tyroneous9/flight-controller/README.md

# flight-controller

# todo

- configure bms to allow i2c flash
- read sensor data
- test outputs from rf, motors
- self restart (from failure)
- signal loss
