tyroneous9/flight-controller/docs/flight_controller_schematic.pdf

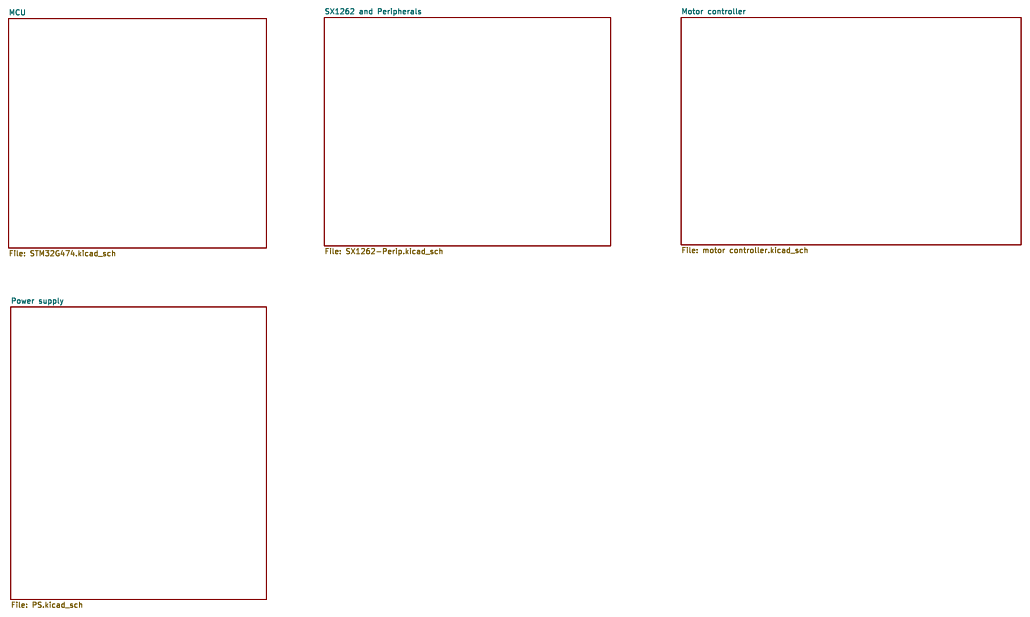
[picture p1: page 1]

Motor controller File: motor controller.kicad_sch

Id: 1/5 Title: File: clarnex123.kicad_sch Sheet: /

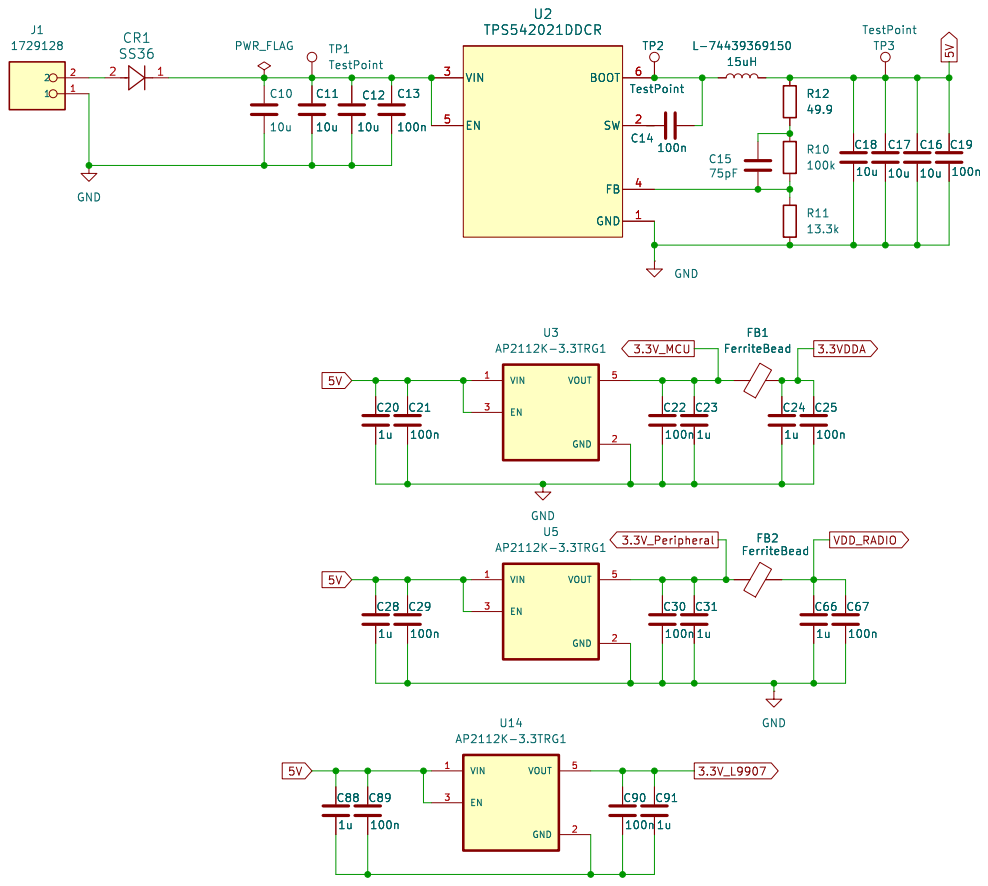
[picture p2: page 2]

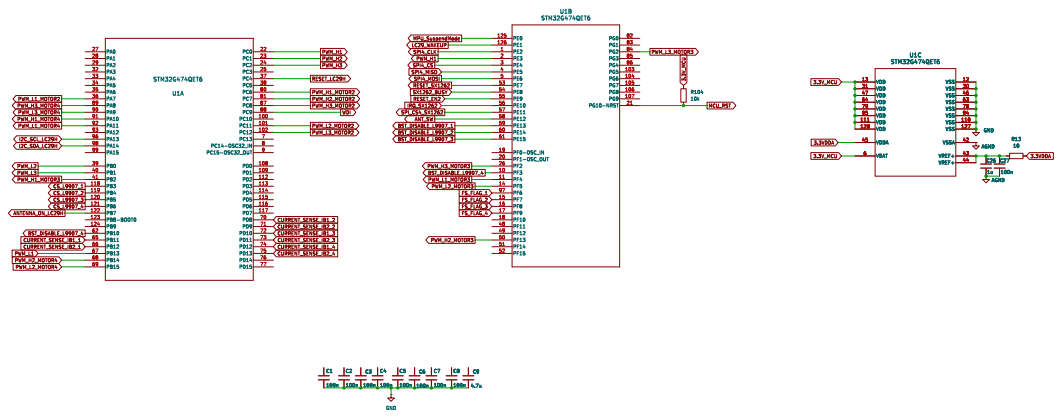
[picture p3: page 3]

Id: 3/5 Title: File: STM32G474.kicad_sch Sheet: /MCU/

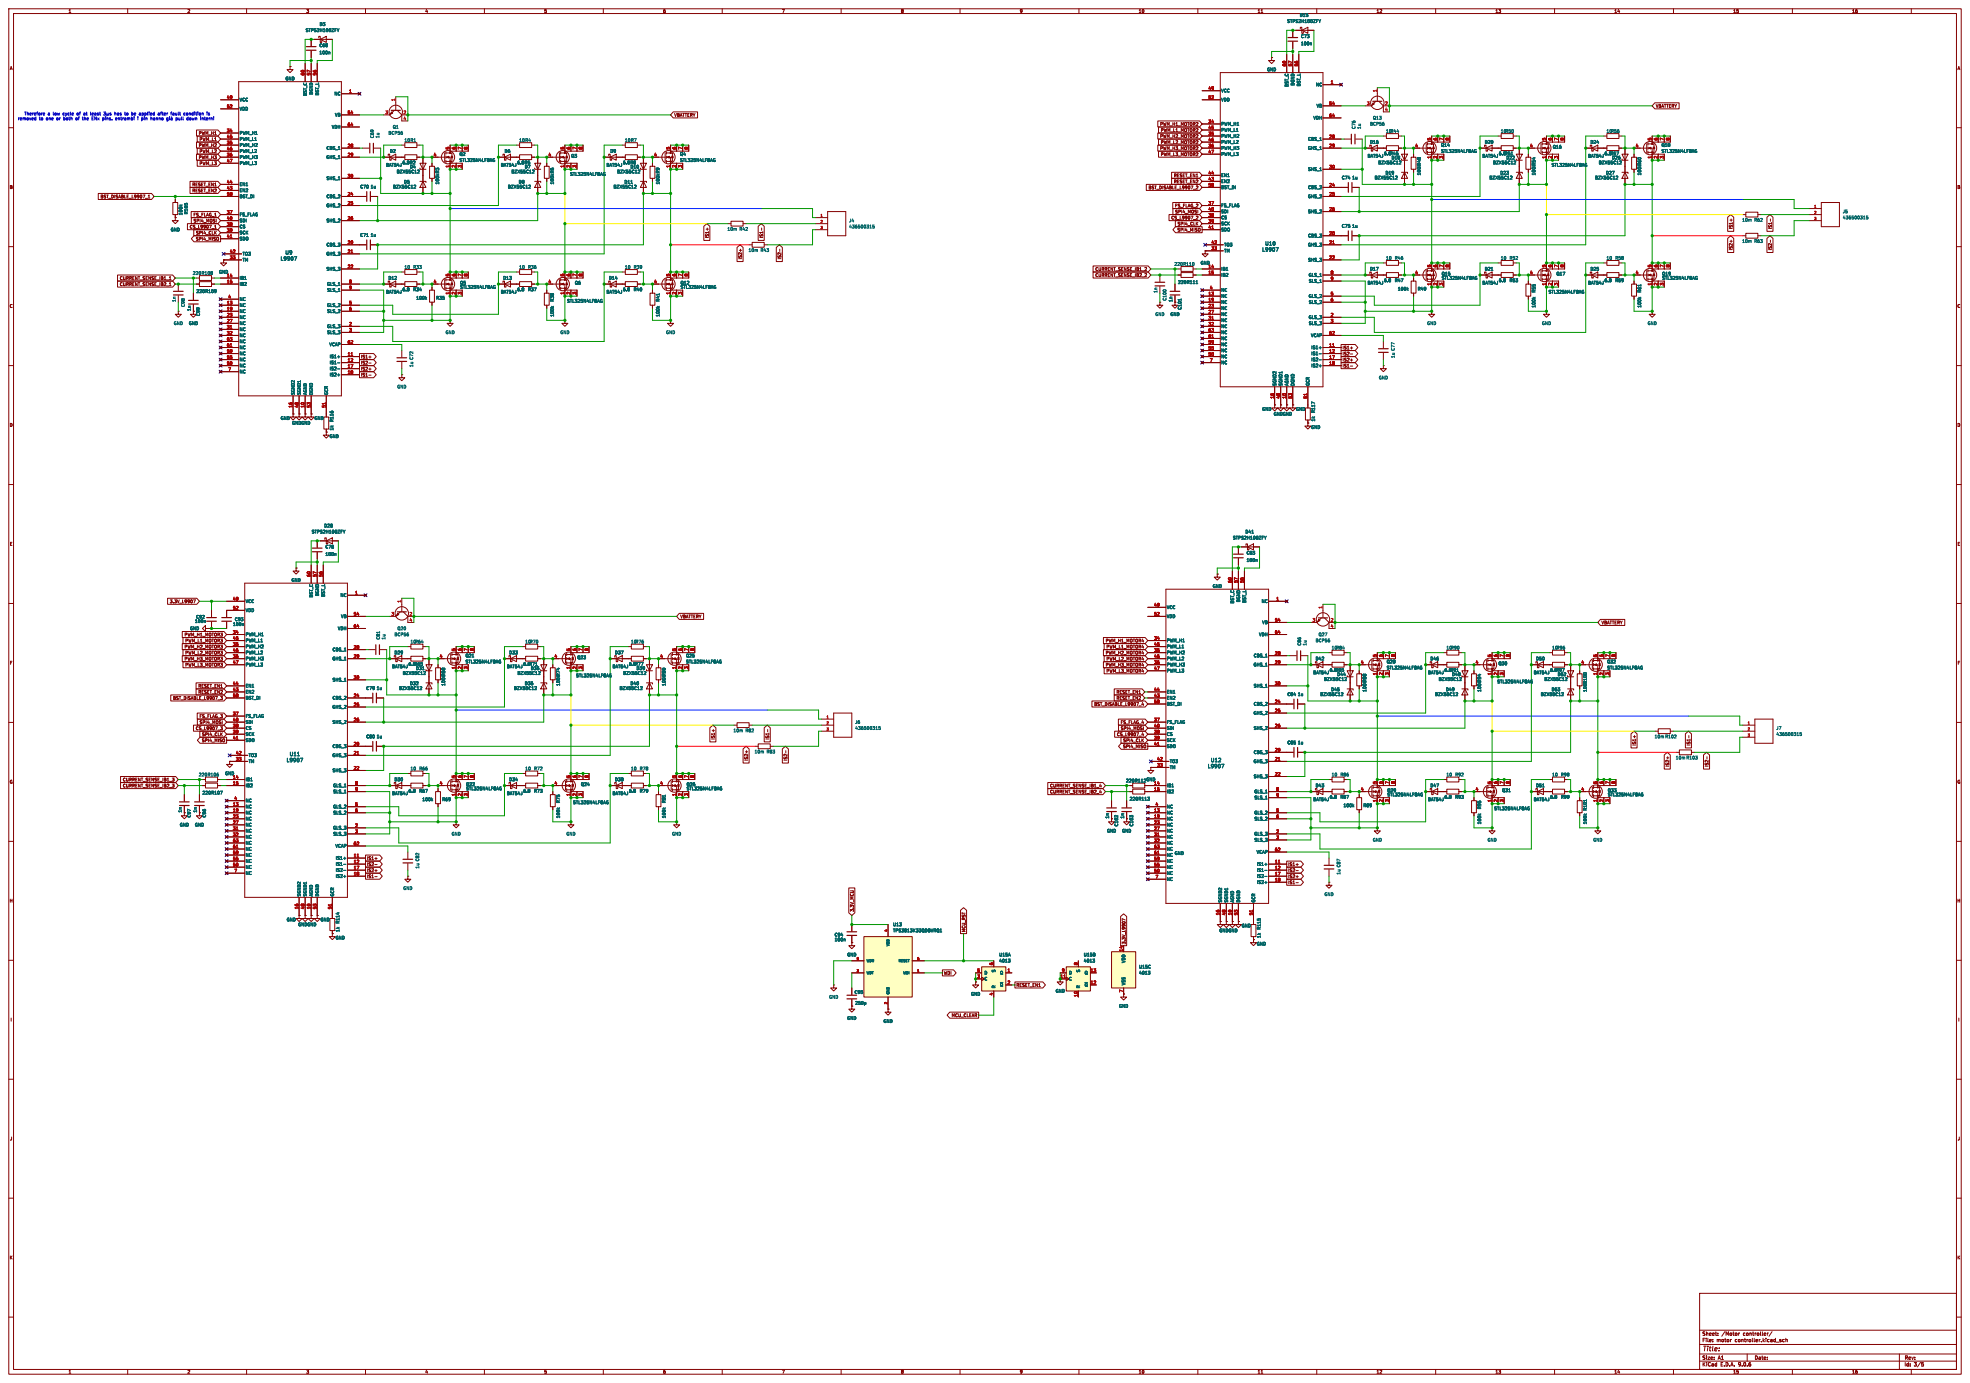
[picture p4: page 4]

GND R95 100k C87 1u R115 1k GNDGND GND GND

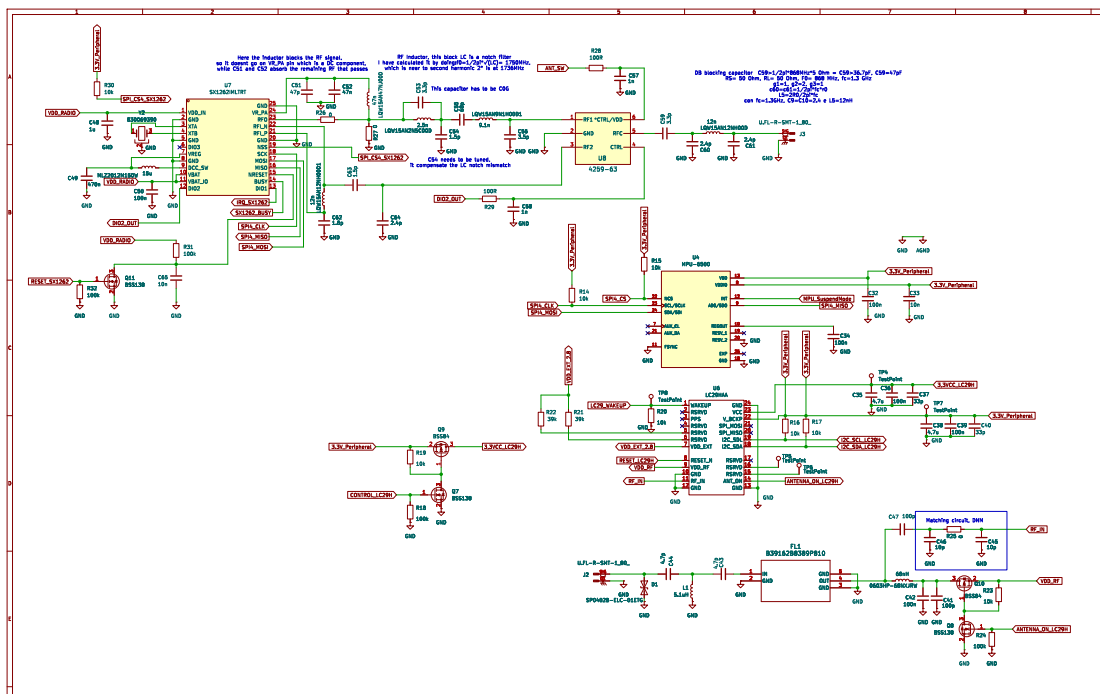
[picture p5: page 5]

C54 needs to be tuned,

I2C_SDA 18 RSRVD 17 RSRVD 16 RSRVD 15 ANT_ON 14 GND 13 R20
