tyroneous9/flight-controller/schematic/STM32G474.kicad_sch

## KiCad design schematic/STM32G474.kicad_sch (2026-10-25)

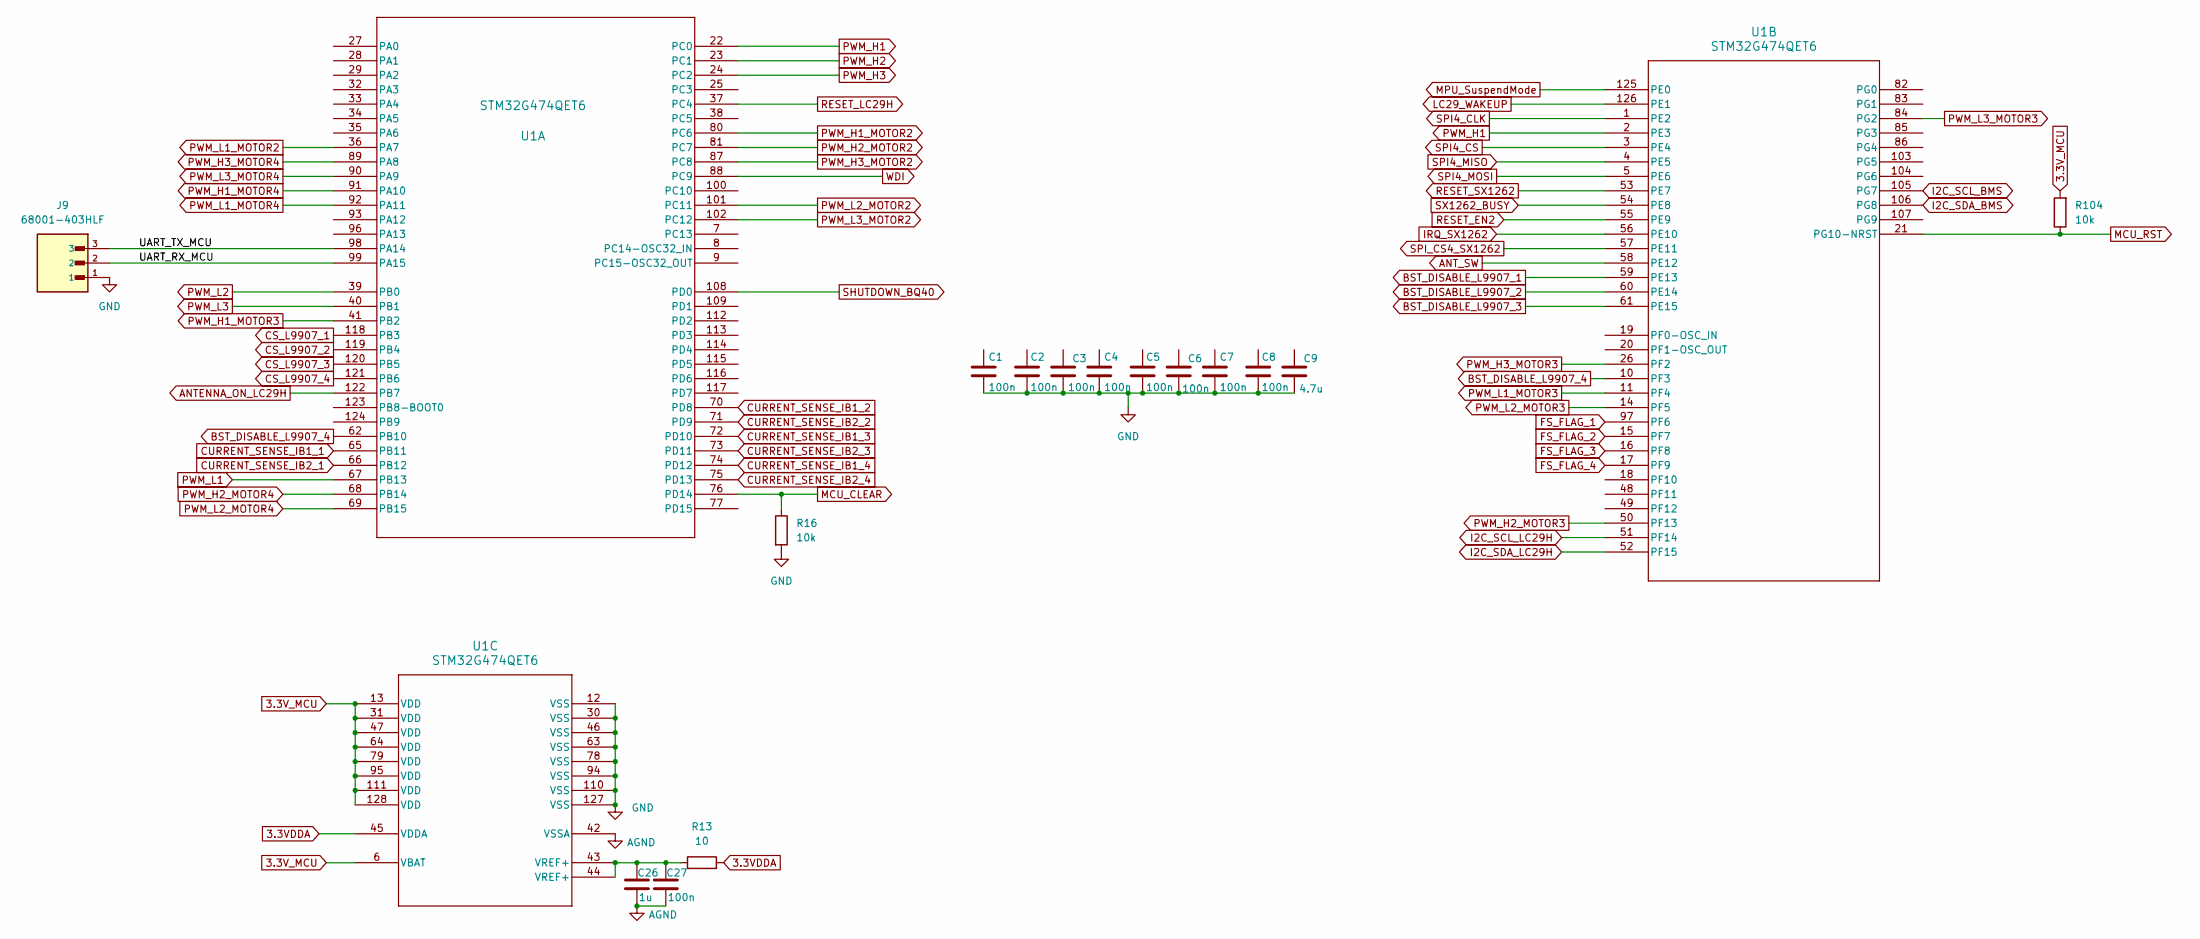
[picture p6: schematic STM32G474.kicad_sch]

Parts:
C1, C2, C3, C4, C5, C6, C7, C8, C27: 100n; C_0603_1608Metric_Pad1.08x0.95mm_HandSolder
C9: 4.7u; C_0603_1608Metric_Pad1.08x0.95mm_HandSolder
C26: 1u; C_0603_1608Metric_Pad1.08x0.95mm_HandSolder
J9: 68001-403HLF; AMPHENOL_68001-403HLF; PARTREV DG
R13: 10; R_0603_1608Metric
R16, R104: 10k; R_0603_1608Metric
U1: STM32G474QET6; LPQFP-128

Connections:
3.3VDDA: R13.2, U1.45 (VDDA)
3.3V_MCU: R104.2, U1.6 (VBAT), U1.13 (VDD), U1.31 (VDD), U1.47 (VDD), U1.64 (VDD), U1.79 (VDD), U1.95 (VDD), U1.111 (VDD), U1.128 (VDD)
ANT_SW: U1.58 (PE12)
AGND: C26.2, C27.2, U1.42 (VSSA)
ANTENNA_ON_LC29H: U1.122 (PB7)
BST_DISABLE_L9907_1: U1.59 (PE13)
BST_DISABLE_L9907_2: U1.60 (PE14)
BST_DISABLE_L9907_3: U1.61 (PE15)
BST_DISABLE_L9907_4: U1.10 (PF3), U1.62 (PB10)
CS_L9907_1: U1.118 (PB3)
CS_L9907_2: U1.119 (PB4)
CS_L9907_3: U1.120 (PB5)
CS_L9907_4: U1.121 (PB6)
CURRENT_SENSE_IB1_1: U1.65 (PB11)
CURRENT_SENSE_IB1_2: U1.70 (PD8)
CURRENT_SENSE_IB1_3: U1.72 (PD10)
CURRENT_SENSE_IB1_4: U1.74 (PD12)
CURRENT_SENSE_IB2_1: U1.66 (PB12)
CURRENT_SENSE_IB2_2: U1.71 (PD9)
CURRENT_SENSE_IB2_3: U1.73 (PD11)
CURRENT_SENSE_IB2_4: U1.75 (PD13)
FS_FLAG_1: U1.97 (PF6)
FS_FLAG_2: U1.15 (PF7)
FS_FLAG_3: U1.16 (PF8)
FS_FLAG_4: U1.17 (PF9)
GND: C1.2, C2.2, C3.2, C4.2, C5.2, C6.2, C7.2, C8.2, C9.2, J9.1, R16.2, U1.12 (VSS), U1.30 (VSS), U1.46 (VSS), U1.63 (VSS), U1.78 (VSS), U1.94 (VSS), U1.110 (VSS), U1.127 (VSS)
I2C_SCL_BMS: U1.105 (PG7)
I2C_SCL_LC29H: U1.51 (PF14)
I2C_SDA_BMS: U1.106 (PG8)
I2C_SDA_LC29H: U1.52 (PF15)
IRQ_SX1262: U1.56 (PE10)
LC29_WAKEUP: U1.126 (PE1)
MCU_CLEAR: R16.1, U1.76 (PD14)
MCU_RST: R104.1, U1.21 (PG10-NRST)
MPU_SuspendMode: U1.125 (PE0)
unnamed: C26.1, C27.1, R13.1, U1.43 (VREF+), U1.44 (VREF+)
PWM_H1: U1.2 (PE3), U1.22 (PC0)
PWM_H1_MOTOR2: U1.80 (PC6)
PWM_H1_MOTOR3: U1.41 (PB2)
PWM_H1_MOTOR4: U1.91 (PA10)
PWM_H2: U1.23 (PC1)
PWM_H2_MOTOR2: U1.81 (PC7)
PWM_H2_MOTOR3: U1.50 (PF13)
PWM_H2_MOTOR4: U1.68 (PB14)
PWM_H3: U1.24 (PC2)
PWM_H3_MOTOR2: U1.87 (PC8)
PWM_H3_MOTOR3: U1.26 (PF2)
PWM_H3_MOTOR4: U1.89 (PA8)
PWM_L1: U1.67 (PB13)
PWM_L1_MOTOR2: U1.36 (PA7)
PWM_L1_MOTOR3: U1.11 (PF4)
PWM_L1_MOTOR4: U1.92 (PA11)
PWM_L2: U1.39 (PB0)
PWM_L2_MOTOR2: U1.101 (PC11)
PWM_L2_MOTOR3: U1.14 (PF5)
PWM_L2_MOTOR4: U1.69 (PB15)
PWM_L3: U1.40 (PB1)
PWM_L3_MOTOR2: U1.102 (PC12)
PWM_L3_MOTOR3: U1.84 (PG2)
PWM_L3_MOTOR4: U1.90 (PA9)
RESET_EN2: U1.55 (PE9)
RESET_LC29H: U1.37 (PC4)
RESET_SX1262: U1.53 (PE7)
SHUTDOWN_BQ40: U1.108 (PD0)
SPI4_CLK: U1.1 (PE2)
SPI4_CS: U1.3 (PE4)
SPI4_MISO: U1.4 (PE5)
SPI4_MOSI: U1.5 (PE6)
SPI_CS4_SX1262: U1.57 (PE11)
SX1262_BUSY: U1.54 (PE8)
UART_RX_MCU: J9.2, U1.99 (PA15)
UART_TX_MCU: J9.3, U1.98 (PA14)
WDI: U1.88 (PC9)
