tyroneous9/flight-controller/schematic/SX1262-Perip.kicad_sch

## KiCad design schematic/SX1262-Perip.kicad_sch (2026-10-25)

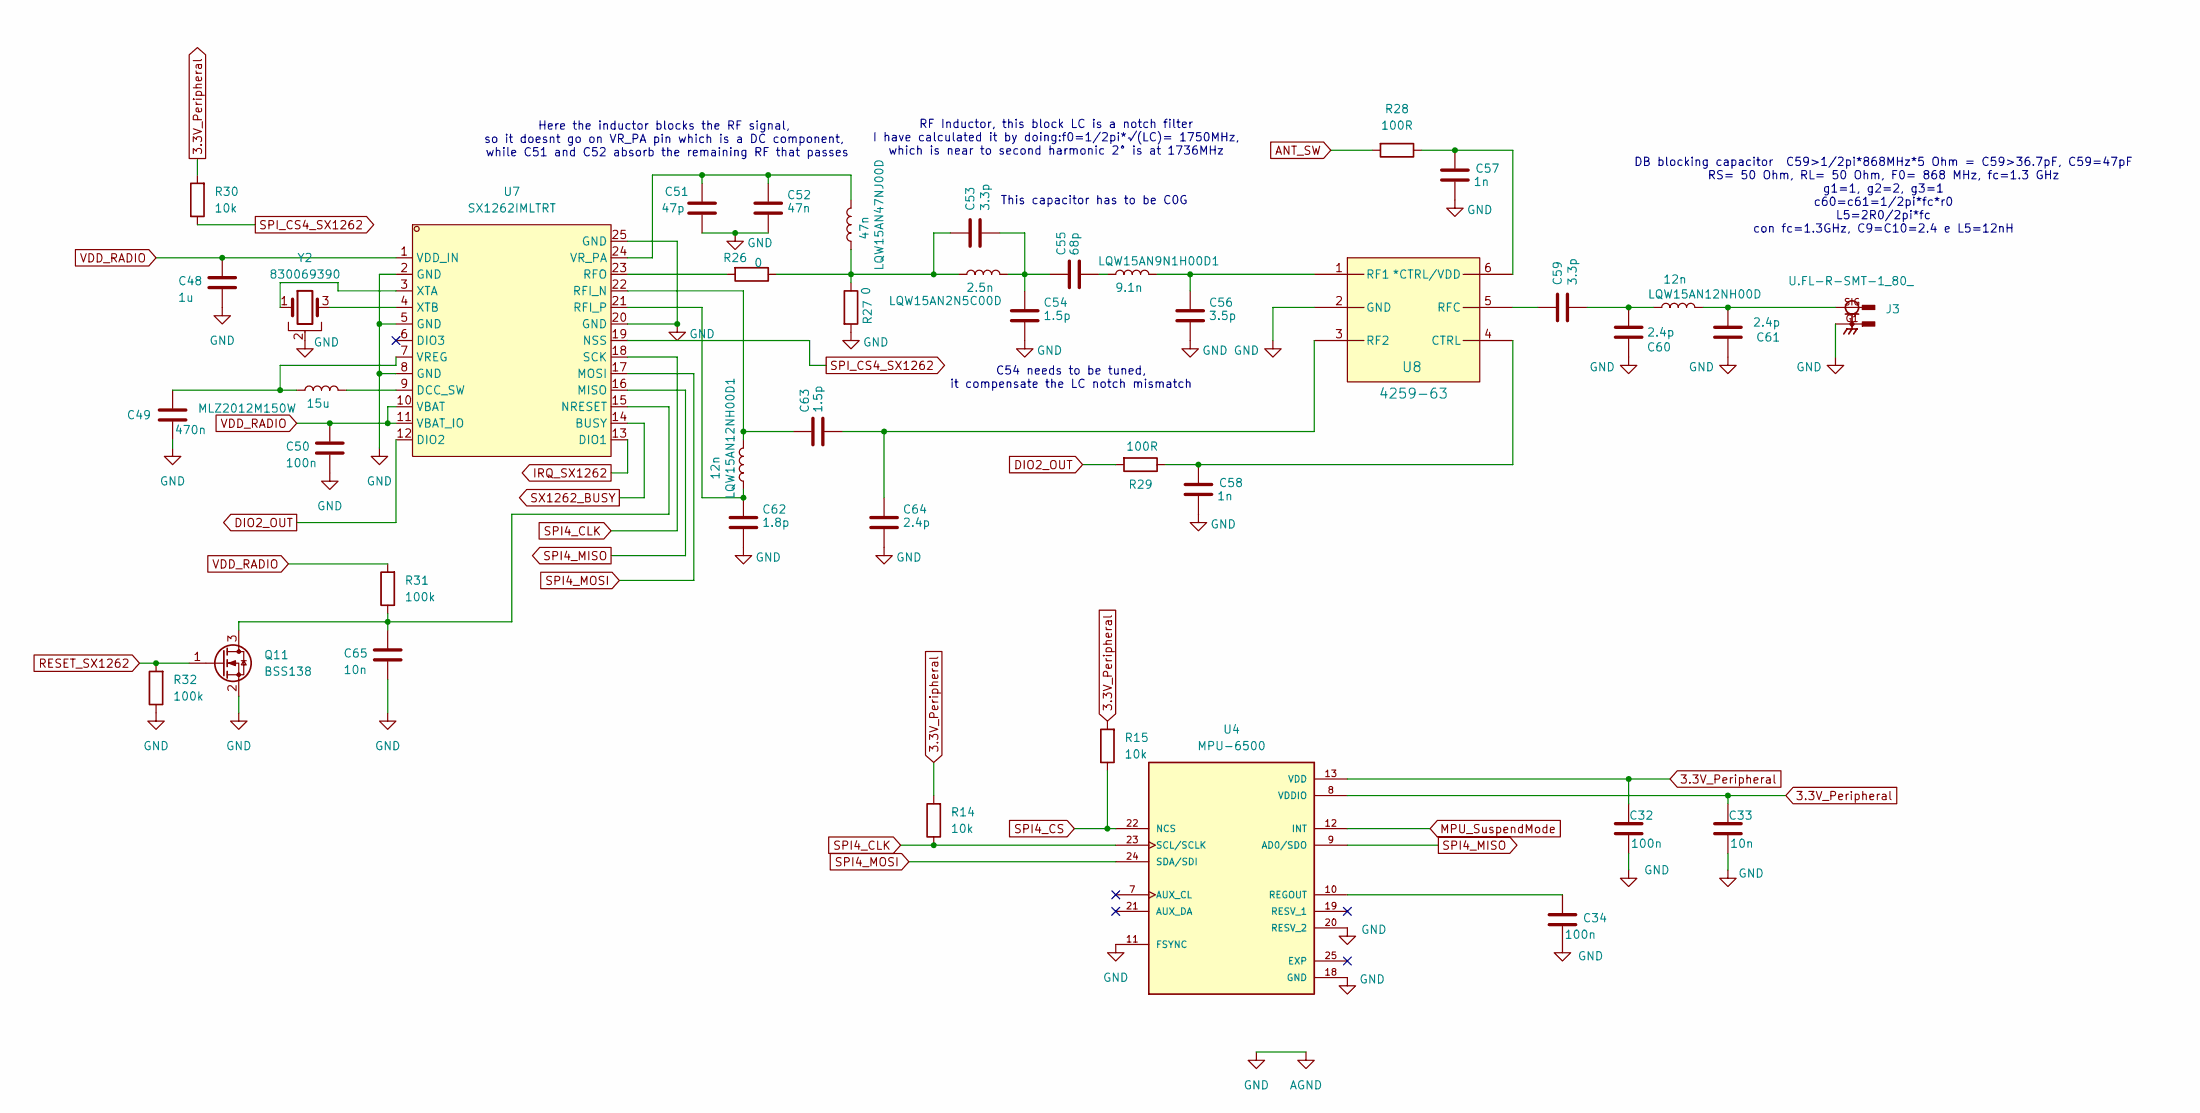
[picture p7: schematic SX1262-Perip.kicad_sch]

Parts:
C32, C34: 100n; C_0603_1608Metric_Pad1.08x0.95mm_HandSolder
C33: 10n; C_0603_1608Metric_Pad1.08x0.95mm_HandSolder
C48: 1u
C49: 470n; C_0603_1608Metric_Pad1.08x0.95mm_HandSolder
C50: 100n
C51: 47p
C52: 47n
C53, C59: 3.3p; C_01005_0402Metric
C54, C63: 1.5p
C55: 68p
C56: 3.5p
C57, C58: 1n
C60, C61: 2.4p; C_01005_0402Metric
C62: 1.8p
C64: 2.4p
C65: 10n
J3: U.FL-R-SMT-1_80_; HIROSE_U.FL-R-SMT-1_80_; PARTREV Jul.1.2022
LQW15AN2N5C00D: 2.5n; L_0402_1005Metric
LQW15AN9N1H00D1: 9.1n; L_0402_1005Metric
LQW15AN12NH00D, LQW15AN12NH00D1: 12n; L_0402_1005Metric
LQW15AN47NJ00D: 47n; L_0402_1005Metric
MLZ2012M150W: 15u; L_0805_2012Metric
Q11: BSS138; SOT-23
R14, R15, R30: 10k; R_0603_1608Metric
R26, R27: 0; R_0603_1608Metric
R28, R29: 100R; R_0603_1608Metric
R31, R32: 100k; R_0603_1608Metric
U4: MPU-6500; QFN40P300X300X95-25N; PARTREV 1.3
U7: SX1262IMLTRT; QFN-24_L4.0-W4.0-P0.50-BL-EP2.6; MPN SX1262IMLTRT; LCSC Part C191341
U8: 4259-63; SC-70-6_PSM
Y2: 830069390; Crystal_SMD_Abracon_ABM10-4Pin_2.5x2.0mm

Connections:
3.3V_Peripheral: C32.1, C33.1, R14.2, R15.2, R30.2, U4.8 (VDDIO), U4.13 (VDD)
ANT_SW: R28.2
AGND: C32.2, C33.2, C34.2, C48.2, C49.2, C50.2, C51.2, C52.2, C54.2, C56.2, C57.2, C58.2, C60.1, C61.1, C62.2, C64.2, C65.2, J3.G1, J3.G2, Q11.2 (S), R27.2, R32.1, U4.11 (FSYNC), U4.18 (GND), U4.20 (RESV_2), U7.2 (GND), U7.5 (GND), U7.8 (GND), U7.20 (GND), U7.25 (GND), U8.2 (GND), Y2.2
DIO2_OUT: R29.2, U7.12 (DIO2)
IRQ_SX1262: U7.13 (DIO1)
MPU_SuspendMode: U4.12 (INT)
unnamed: C34.1, U4.10 (REGOUT)
unnamed: C49.1, MLZ2012M150W.1, U7.7 (VREG)
unnamed: C51.1, C52.1, LQW15AN47NJ00D.2, U7.24 (VR_PA)
unnamed: C53.1, LQW15AN2N5C00D.1, LQW15AN47NJ00D.1, R26.1, R27.1
unnamed: C53.2, C54.1, C55.1, LQW15AN2N5C00D.2
unnamed: C55.2, LQW15AN9N1H00D1.1
unnamed: C56.1, LQW15AN9N1H00D1.2, U8.1 (RF1)
unnamed: C57.1, R28.1, U8.6 (*CTRL/VDD)
unnamed: C58.1, R29.1, U8.4 (CTRL)
unnamed: C59.1, U8.5 (RFC)
unnamed: C59.2, C60.2, LQW15AN12NH00D.1
unnamed: C61.2, J3.SIG, LQW15AN12NH00D.2
unnamed: C62.1, LQW15AN12NH00D1.1, U7.21 (RFI_P)
unnamed: C63.1, LQW15AN12NH00D1.2, U7.22 (RFI_N)
unnamed: C63.2, C64.1, U8.3 (RF2)
unnamed: C65.1, Q11.3 (D), R31.1, U7.15 (NRESET)
unnamed: MLZ2012M150W.2, U7.9 (DCC_SW)
unnamed: R26.2, U7.23 (RFO)
unnamed: U7.3 (XTA), Y2.1
unnamed: U7.4 (XTB), Y2.3
RESET_SX1262: Q11.1 (G), R32.2
SPI4_CLK: R14.1, U4.23 (SCL/SCLK), U7.18 (SCK)
SPI4_CS: R15.1, U4.22 (NCS)
SPI4_MISO: U4.9 (AD0/SDO), U7.16 (MISO)
SPI4_MOSI: U4.24 (SDA/SDI), U7.17 (MOSI)
SPI_CS4_SX1262: R30.1, U7.19 (NSS)
SX1262_BUSY: U7.14 (BUSY)
VDD_RADIO: C48.1, C50.1, R31.2, U7.1 (VDD_IN), U7.10 (VBAT), U7.11 (VBAT_IO)

Notes on the sheet:
C54 needs to be tuned, it compensate the LC notch mismatch
DB blocking capacitor C59>1/2pi*868MHz*5 Ohm = C59>36.7pF, C59=47pF ‌ RS= 50 Ohm, RL= 50 Ohm, F0= 868 MHz, fc=1.3 GHz ‌ g1=1, g2=2, g3=1 ‌ c60=c61=1/2pi*fc*r0 ‌ L5=2R0/2pi*fc ‌ con fc=1.3GHz, C9=C10=2.4 e L5=12nH
This capacitor has to be C0G
RF Inductor, this block LC is a notch filter I have calculated it by doing:f0=1/2pi*√(LC)= 1750MHz, which is near to second harmonic 2° is at 1736MHz
Here the inductor blocks the RF signal, so it doesnt go on VR_PA pin which is a DC component, while C51 and C52 absorb the remaining RF that passes
