tyroneous9/flight-controller/Core/Src/main.c

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
/* Includes ------------------------------------------------------------------*/
#include "main.h"
/* USER CODE BEGIN Includes */
#include <stdio.h>
#include "radio.h"
/* USER CODE END Includes */

SPI_HandleTypeDef hspi2;

UART_HandleTypeDef huart2;

void SystemClock_Config(void);
static void MX_GPIO_Init(void);
static void MX_SPI2_Init(void);
static void MX_USART2_UART_Init(void);
/* USER CODE BEGIN 0 */
int __io_putchar(int ch)
{
    HAL_UART_Transmit(&huart2, (uint8_t *)&ch, 1, HAL_MAX_DELAY);
    return ch;
}
/* USER CODE END 0 */



/**
  * @brief  The application entry point.
  * @retval int
  */
int main(void)
{

  /* MCU Configuration--------------------------------------------------------*/

  /* Reset of all peripherals, Initializes the Flash interface and the Systick. */
  HAL_Init();

  /* Configure the system clock */
  SystemClock_Config();

  /* Initialize all configured peripherals */
  MX_GPIO_Init();
  MX_SPI2_Init();
  MX_USART2_UART_Init();
  /* USER CODE BEGIN 2 */
  if (radio_init() != 0)
  {
    printf("Radio init FAILED\r\n");
    return 1;
  }
  else
  {
    printf("Radio init OK\r\n");
  }
  uint32_t count = 0;
  /* USER CODE END 2 */

  /* Infinite loop */
  /* USER CODE BEGIN WHILE */
  while (1)
  {
    /* USER CODE END WHILE */
    /* USER CODE BEGIN 3 */
    /* TODO: Send a test packet once per loop.
     * - Build a short payload that changes each time, e.g. a counter:
     *     char msg[32];
     *     int n = snprintf(msg, sizeof msg, "hello %lu", count++);
     *   A changing payload lets a receiver tell packets apart and spot drops.
     * - Call radio_transmit((const uint8_t *)msg, n) and print OK/FAILED.
     *   Only transmit if radio_init succeeded.
     * - Airtime: ~20 bytes at SF9/125 kHz takes ~0.2 s, so once per second
     *   is ~20% of the time on air. That's fine in the US, but over the EU's
     *   1% duty-cycle limit at 868 MHz.
     * - No receiver yet? TX_DONE means the chip sent the packet, but not that
     *   it got through. To see the signal, an RTL-SDR dongle with GQRX/SDR#
     *   tuned to 915 MHz shows each packet as a burst of chirps. */
    char msg[32];
    int n = snprintf(msg, sizeof(msg), "count: %lu", count);
    count++;
    if (radio_transmit((const uint8_t *)msg, (uint8_t)n) == 0)
      printf("TX OK: %s\r\n", msg);
    else
      printf("TX FAILED\r\n");
    radio_print_status();
    HAL_Delay(1000);
  }
  /* USER CODE END 3 */
}

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
