tyroneous9/flight-controller/Core/Inc/main.h

#define B1_Pin GPIO_PIN_13
#define B1_GPIO_Port GPIOC
#define USART_TX_Pin GPIO_PIN_2
#define USART_TX_GPIO_Port GPIOA
#define USART_RX_Pin GPIO_PIN_3
#define USART_RX_GPIO_Port GPIOA
#define LD2_Pin GPIO_PIN_5
#define LD2_GPIO_Port GPIOA
#define RADIO_SCK_Pin GPIO_PIN_13
#define RADIO_SCK_GPIO_Port GPIOB
#define RADIO_MISO_Pin GPIO_PIN_14
#define RADIO_MISO_GPIO_Port GPIOB
#define RADIO_MOSI_Pin GPIO_PIN_15
#define RADIO_MOSI_GPIO_Port GPIOB
#define RADIO_RF_SW1_Pin GPIO_PIN_7
#define RADIO_RF_SW1_GPIO_Port GPIOC
#define RADIO_BUSY_Pin GPIO_PIN_8
#define RADIO_BUSY_GPIO_Port GPIOA
#define RADIO_RST_Pin GPIO_PIN_9
#define RADIO_RST_GPIO_Port GPIOA
#define TMS_Pin GPIO_PIN_13
#define TMS_GPIO_Port GPIOA
#define TCK_Pin GPIO_PIN_14
#define TCK_GPIO_Port GPIOA
#define SWO_Pin GPIO_PIN_3
#define SWO_GPIO_Port GPIOB
#define RADIO_DIO1_Pin GPIO_PIN_5
#define RADIO_DIO1_GPIO_Port GPIOB
#define RADIO_DIO1_EXTI_IRQn EXTI9_5_IRQn
#define RADIO_NSS_Pin GPIO_PIN_6
#define RADIO_NSS_GPIO_Port GPIOB
