tyroneous9/flight-controller/Components/radio/radio.c

#include "radio.h"

#include <stdio.h>
#include "sx126x.h"
#include "main.h"

/* ---------------------------------------------------------------------------
 * Clock (TCXO)
 * ------------------------------------------------------------------------- */

/* The Wio-SX1262's 32 MHz reference is a TCXO powered from DIO3.
 * This can be removed later when replacing this module with one that has a crystal. */
#define RADIO_TCXO_VOLTAGE  SX126X_TCXO_CTRL_1_8V
#define RADIO_TCXO_DELAY    320

/* ---------------------------------------------------------------------------
 * Frequency
 * ------------------------------------------------------------------------- */

/* Center frequency of the signal:
 * US: 902-928 MHz,  EU: 863-870 MHz
 * The band limits are only used for image calibration. */
#define RADIO_FREQ_HZ       915000000UL
#define RADIO_BAND_MIN_MHZ  902
#define RADIO_BAND_MAX_MHZ  928

/* ---------------------------------------------------------------------------
 * LoRa modulation (RadioLib's SX126x defaults).
 * ------------------------------------------------------------------------- */

/* Spreading factor: bits per chirp, SF5..SF12. Each step up doubles the time
 * per chirp (slower but more range). */
#define RADIO_SF            SX126X_LORA_SF9

/* Bandwidth: how wide a range of frequencies each chirp sweeps.
 * Wider = faster but shorter range */
#define RADIO_BW            SX126X_LORA_BW_125

/* Coding rate: error-correction overhead. 4/7 sends every 4 data bits as 7.
 * Options 4/5 (fastest, least protection) .. 4/8 (slowest, most). */
#define RADIO_CR            SX126X_LORA_CR_4_7

/* Preamble: plain chirps at the start of each packet that let the receiver notice a packet. 
 * Longer makes packets easier to catch but costs airtime. */
#define RADIO_PREAMBLE_LEN  8

/* Transmit power in dBm (10 dBm = 10 mW). 
 * The SX1262's PA allows -9..+22 dBm. +3 dB = 2x power; +6 dB = ~2x range in open space. */
#define RADIO_TX_POWER_DBM  10

/* Return -1 from the calling function if an sx126x_* call fails, and also names it. */
#define RADIO_CHECK(call)                                 \
  do                                                      \
  {                                                       \
    if ((call) != SX126X_STATUS_OK)                       \
    {                                                     \
      printf("Radio call failed: %s\r\n", #call);         \
      return -1;                                          \
    }                                                     \
  } while (0)

/* Power amplifier (PA) settings.
 * The changes are applied by set_pa_cfg(). */
static sx126x_pa_cfg_params_t pa_cfg = {
  .pa_duty_cycle = 0x04, /* PA on-time per cycle; SX1262 max is 0x04 */
  .hp_max = 0x07,        /* size of the PA, 0x00..0x07 (max) */
  .device_sel = 0x00,    /* 0 = SX1262 */
  .pa_lut = 0x01,        /* reserved, always 0x01 */
};

/* Modulation settings */
static sx126x_mod_params_lora_t mod_params = {
  .sf = RADIO_SF,
  .bw = RADIO_BW,
  .cr = RADIO_CR,
  /* Low data rate optimization: compensates for clock drift when chirps are very long (over ~16 ms). */
  .ldro = 0,
};

/* Packet format settings */
static sx126x_pkt_params_lora_t pkt_params = {
  .preamble_len_in_symb = RADIO_PREAMBLE_LEN,
  /* Explicit sends the header including settings, so receiver doesn't need SOME preset configs. */
  .header_type = SX126X_LORA_PKT_EXPLICIT,
  /* Payload length in bytes (max 255). Is set again per packet depending on its length. */
  .pld_len_in_bytes = 255,
  /* Checksum on the payload, so the receiver can drop corrupted packets. */
  .crc_is_on = true,
  /* Inverted IQ flips the chirp direction. Unnecessary here. */
  .invert_iq_is_on = false,
};

void radio_print_status(void)
{
  sx126x_chip_status_t status = {0};
  sx126x_status_t get_status = sx126x_get_status(NULL, &status);
  if(get_status != SX126X_STATUS_OK)
  {
    printf("Failed to get status: %d\r\n", get_status);
  }
  else
  {
    printf("Radio status: %d\r\n", status.chip_mode);
  }
  /* chip status reference:
    2 = STBY_RC   3 = STBY_XOSC   4 = FS   5 = RX   6 = TX */
}

/* Apply settings to the radio. */
int radio_init(void)
{
  sx126x_errors_mask_t errors = 0;
  sx126x_chip_status_t status = {0};

  /* Clean state, then set standby (most setup commands only work during standby). */
  RADIO_CHECK(sx126x_reset(NULL));
  RADIO_CHECK(sx126x_set_standby(NULL, SX126X_STANDBY_CFG_RC));

  /* Power the TCXO from DIO3, then clear TCXO related errors from startup. */
  RADIO_CHECK(sx126x_set_dio3_as_tcxo_ctrl(NULL, RADIO_TCXO_VOLTAGE, RADIO_TCXO_DELAY));
  RADIO_CHECK(sx126x_clear_device_errors(NULL));

  /* Recalibrate chip now that it can use TCXO clock. */
  RADIO_CHECK(sx126x_cal(NULL, SX126X_CAL_ALL));

  /* LoRa setup. The chip defaults to FSK mode, so it needs to be set to LoRa. */
  RADIO_CHECK(sx126x_set_pkt_type(NULL, SX126X_PKT_TYPE_LORA));

  /* Frequency, then tune the receiver's image rejection for this band. */
  RADIO_CHECK(sx126x_set_rf_freq(NULL, RADIO_FREQ_HZ));
  RADIO_CHECK(sx126x_cal_img_in_mhz(NULL, RADIO_BAND_MIN_MHZ, RADIO_BAND_MAX_MHZ));

  RADIO_CHECK(sx126x_set_lora_mod_params(NULL, &mod_params));
  RADIO_CHECK(sx126x_set_lora_pkt_params(NULL, &pkt_params));

  /* Apply PA settings, then output power and ramp time.
   * Ramp time: how quickly the PA turns on and off for each transmission. */
  RADIO_CHECK(sx126x_set_pa_cfg(NULL, &pa_cfg));
  RADIO_CHECK(sx126x_set_tx_params(NULL, RADIO_TX_POWER_DBM, SX126X_RAMP_200_US));

  /* Enable DIO2 to automatically switch the antenna between transmit and receive. */
  RADIO_CHECK(sx126x_set_dio2_as_rf_sw_ctrl(NULL, true));

  /* Set to TCXO standby and get errors/status. */
  RADIO_CHECK(sx126x_set_standby(NULL, SX126X_STANDBY_CFG_XOSC));
  RADIO_CHECK(sx126x_get_device_errors(NULL, &errors));
  RADIO_CHECK(sx126x_get_status(NULL, &status));

  if (errors != 0 || status.chip_mode != SX126X_CHIP_MODE_STBY_XOSC)
  {
    /* 0x0020 (XOSC_START): the TCXO didn't start. */
    printf("Radio init: errors = 0x%04X, chip mode = %d\r\n", errors, status.chip_mode);
    return -1;
  }

  return 0;
}

/* Transmits a packet containing len bytes from the radio. */
int radio_transmit(const uint8_t *data, uint8_t len)
{
  /* len is a uint8_t, so it can't exceed 255: the most the buffer holds. */
  if (data == NULL || len == 0)
  {
    return -1;
  }

  /* The SX1262 has one 256-byte RAM buffer shared by TX and RX. Start the payload from the buffer start. */
  RADIO_CHECK(sx126x_set_buffer_base_address(NULL, 0, 0));
  RADIO_CHECK(sx126x_write_buffer(NULL, 0, data, len));

  /* The chip sends exactly pld_len_in_bytes bytes, so the params should be updated per packet.
   * Otherwise every packet would be 255 bytes. */
  pkt_params.pld_len_in_bytes = len;
  RADIO_CHECK(sx126x_set_lora_pkt_params(NULL, &pkt_params));

  /* Setting to record only TX_DONE and TIMEOUT in the IRQ status register, then clear old flags. */
  RADIO_CHECK(sx126x_set_dio_irq_params(NULL, SX126X_IRQ_TX_DONE | SX126X_IRQ_TIMEOUT, 0, 0, 0));
  RADIO_CHECK(sx126x_clear_irq_status(NULL, SX126X_IRQ_ALL));

  /* Expected air time is calculated from the LoRa formula (SF, BW, CR, preamble, payload length).
   * Must come after pld_len_in_bytes is set. */
  uint32_t expected_airtime = sx126x_get_lora_time_on_air_in_ms(&pkt_params, &mod_params);
  RADIO_CHECK(sx126x_set_tx(NULL, expected_airtime + 100));

  /* Poll the IRQ status until TX finishes or the chip times out */
  sx126x_irq_mask_t status = 0;
  uint32_t start = HAL_GetTick();
  while(1)
  {
    RADIO_CHECK(sx126x_get_irq_status(NULL, &status));

    if((status & SX126X_IRQ_TX_DONE) != 0)
    {
      RADIO_CHECK(sx126x_clear_irq_status(NULL, status));
      break;
    }

    /* Chip's own TX timer expired before the packet finished */
    if((status & SX126X_IRQ_TIMEOUT) != 0)
    {
      return -1;
    }

    /* Transmit deadline due to no response */
    if(HAL_GetTick() - start > expected_airtime + 200)
    {
      return -1;
    }
  }

  return 0;
}
