tyroneous9/flight-controller/(commit log)

2026-10-20 added datasheets + schematic
2026-10-25 added sx126x driver
2026-10-25 add schematic explanation
2026-10-26 configured pins for sx1262 spi
2026-10-27 test print over uart
2026-10-27 fix print bug
2026-10-29 added print status
